gfwilliams/XPhotonics_X1_Pro_CNC/xlaserlab.stl

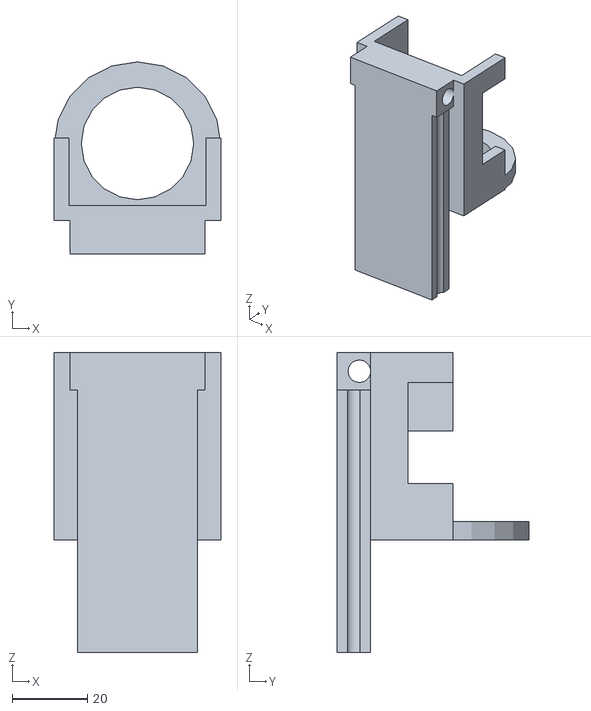
[picture p2: CAD file, 2025-06-23]
xlaserlab.stl
44.5 x 51.2 x 80.0
