gfwilliams/XPhotonics_X1_Pro_CNC/(threads)

Thread 1 (2025-06-29):

recommendation for the readme

obj-imp, 2025-06-29:
thanks for putting this together.

for those who don't want to solder up a custom connector or modify the existing one, can use a DB25 breakout board like [this](https://www.amazon.com/Jienk-Terminal-Breakout-Changer-Connector/dp/B0B73HP42R/) or [this](https://www.amazon.com/CZH-LABS-Diagnostic-Breakout-Connector-Female/dp/B00UWP2UJW/)

this is also a great way to connect a foot pedal to the machine.
